nanbuwks/AKBONE2020/README.md

# AKBONE2020LGT8F

ハンダ付トレーニングキット AKBONE2020 です。
価格を抑えるために LGT8F マイコンを採用しています。
秋葉原ロボット部で開発しているトレーニングキット AKBONE の 2020 年版です。
