nanbuwks/AKBONE2020/(commit log)

2021-01-13 fix readme
    [AKBONE2020LGT8F-B_Cu.gbr, AKBONE2020LGT8F-B_Mask.gbr, AKBONE2020LGT8F-B_SilkS.gbr, AKBONE2020LGT8F-Edge_Cuts.gbr, AKBONE2020LGT8F-F_Cu.gbr, AKBONE2020LGT8F-F_Mask.gbr, AKBONE2020LGT8F-F_SilkS.gbr, AKBONE2020LGT8F-NPTH.drl]
2021-11-29 add reset trim registance (Ver.20211129)
    [AKBONE2020LGT8F-B_Cu.gbr, AKBONE2020LGT8F-B_Mask.gbr, AKBONE2020LGT8F-B_SilkS.gbr, AKBONE2020LGT8F-Edge_Cuts.gbr, AKBONE2020LGT8F-F_Cu.gbr, AKBONE2020LGT8F-F_Mask.gbr, AKBONE2020LGT8F-F_SilkS.gbr, AKBONE2020LGT8F-NPTH.drl]
